Kanope59/DIY_PM/Doc/img/MFG_ABX00017.webp

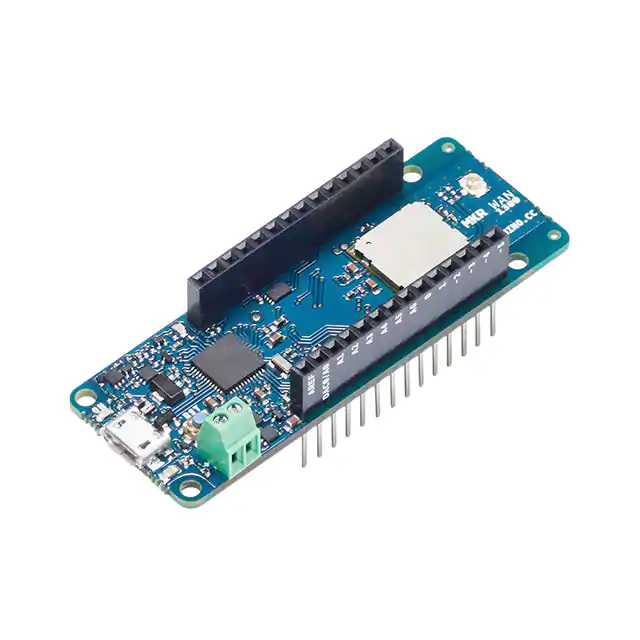
Doc/img/MFG_ABX00017.webp
