Kanope59/DIY_PM/Doc/Doc App.pdf

# Documentation Application kit PM

Partie élève | 2
Connexion | 2
Affichage des données | 3
Partie Professeur | 4
Connexion | 4
Création d’un groupe | 5

Auteur : Loïc Lawniczak

Version : 1.0

Date de révision : 01/02/2021

## Partie élève

### Connexion

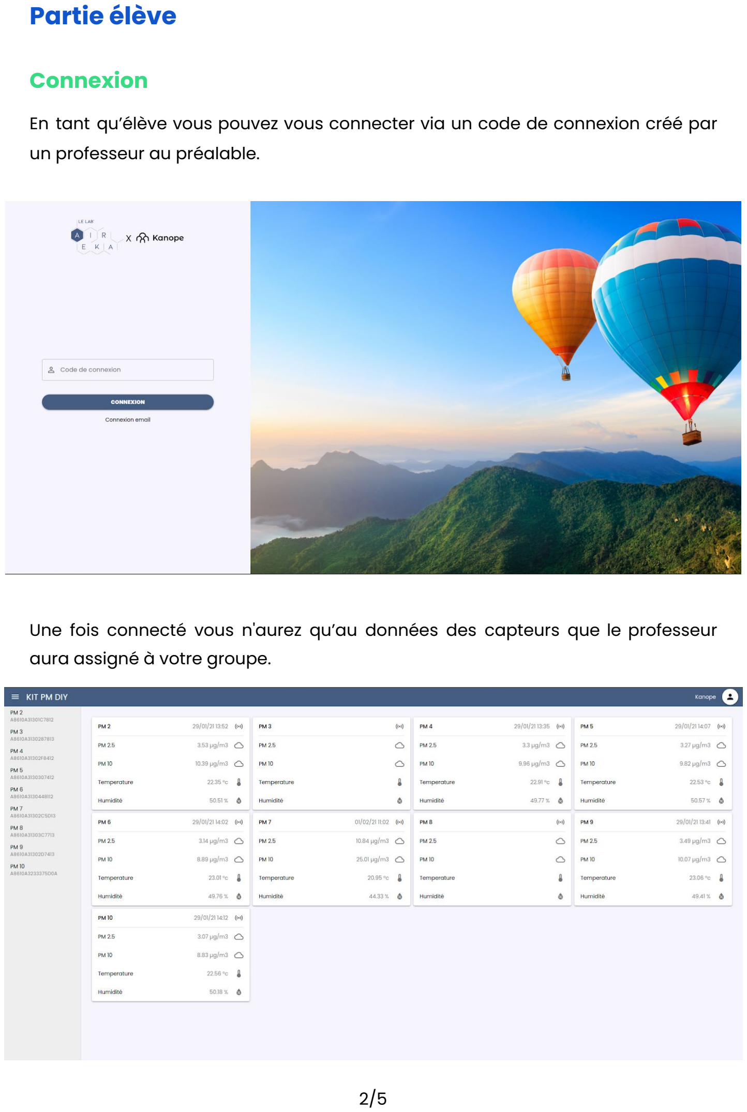
[picture p2: page 2]

En tant qu’élève vous pouvez vous connecter via un code de connexion créé par un professeur au préalable.

Une fois connecté vous n'aurez qu’au données des capteurs que le professeur aura assigné à votre groupe.

### Affichage des données

Dans le menu latéral vous pouvez sélectionner un ou plusieurs capteurs.
Si un seul capteur est sélectionné vous aurez accès à ses données, si vous en sélectionnez plusieurs, les graphiques affichent toutes les courbes ce qui vous permettra de les comparer.

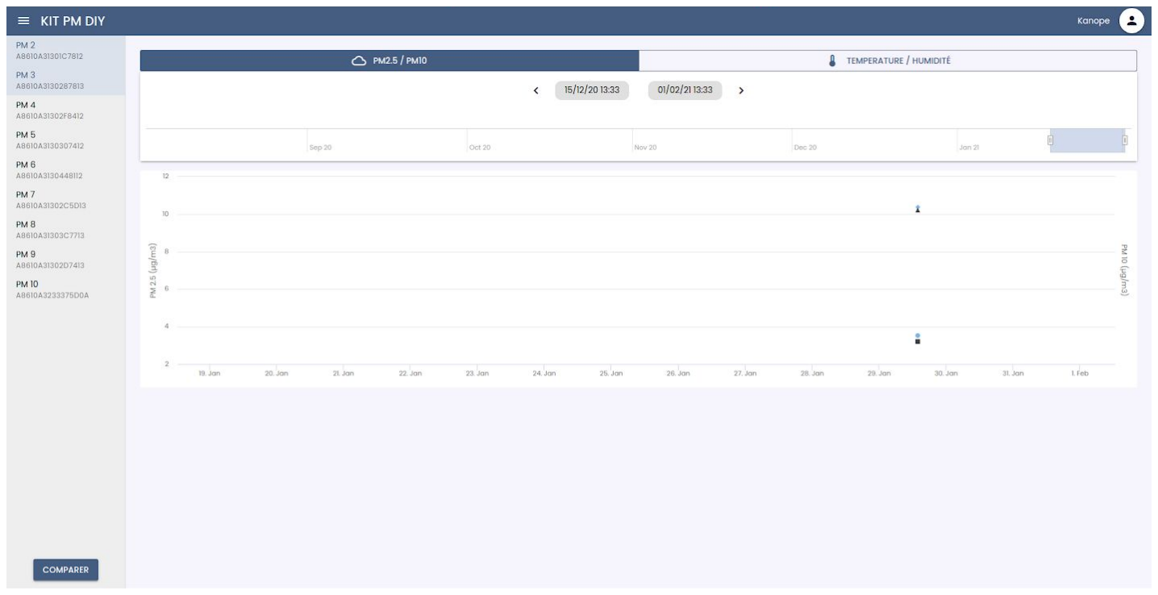
[picture p3: figure]

## Partie Professeur

### Connexion

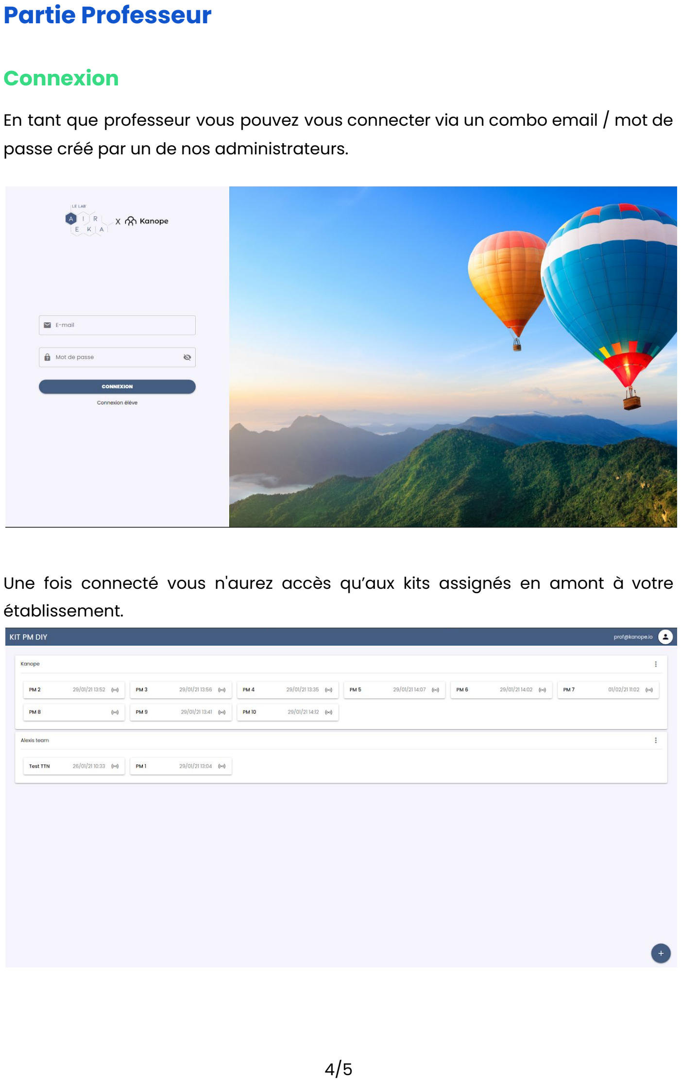
[picture p4: page 4]

En tant que professeur vous pouvez vous connecter via un combo email / mot de passe créé par un de nos administrateurs.

Une fois connecté vous n'aurez accès qu’aux kits assignés en amont à votre établissement.

### Création d’un groupe

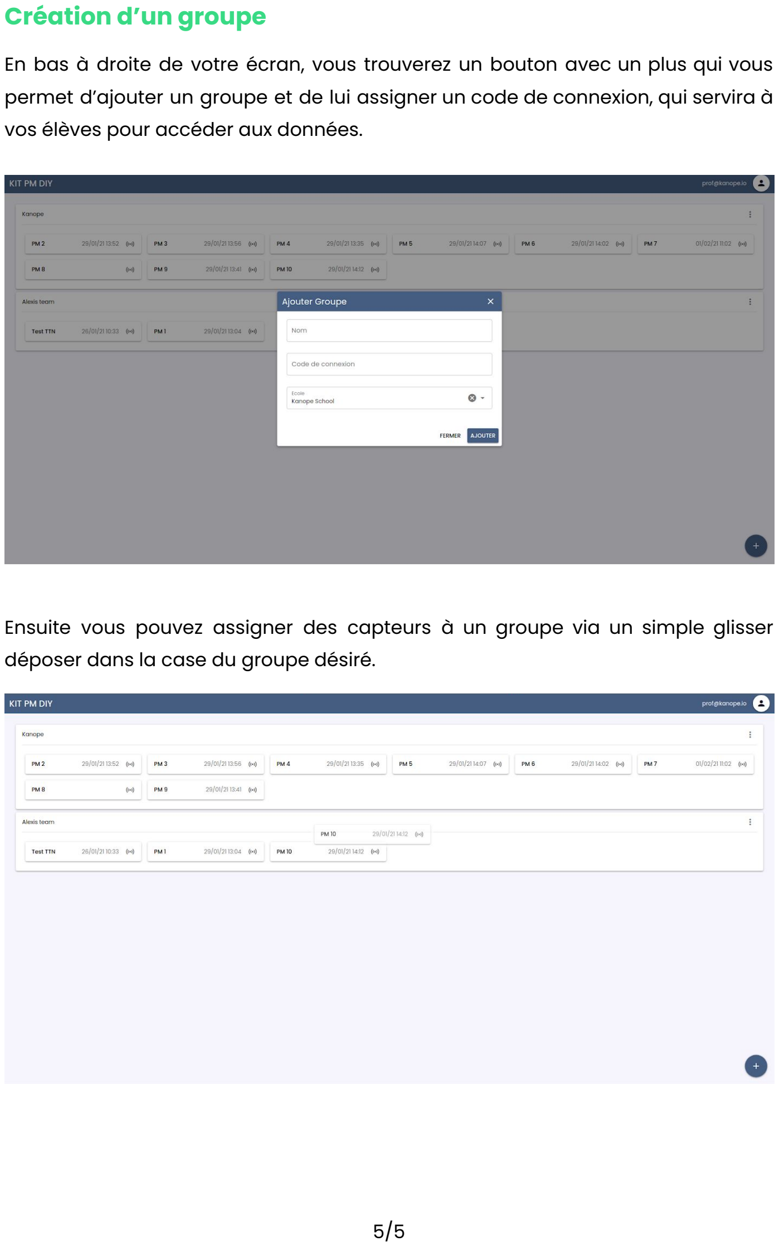
[picture p5: page 5]

En bas à droite de votre écran, vous trouverez un bouton avec un plus qui vous permet d’ajouter un groupe et de lui assigner un code de connexion, qui servira à vos élèves pour accéder aux données.

Ensuite vous pouvez assigner des capteurs à un groupe via un simple glisser déposer dans la case du groupe désiré.
