Kanope59/DIY_PM/Doc/img/41+2ruqOWnL._AC_SL1100_.jpg

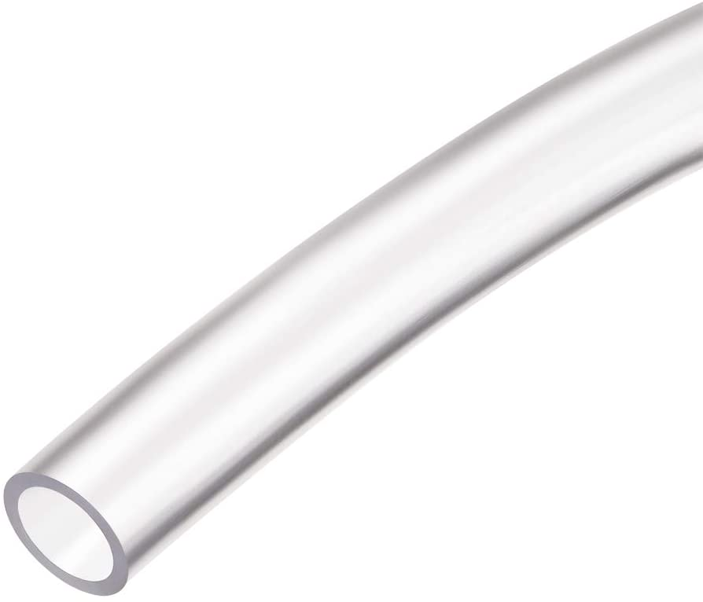
Doc/img/41+2ruqOWnL._AC_SL1100_.jpg
