Kanope59/DIY_PM/Doc/img/51ZyulYqHfL._AC_SL1280_.jpg

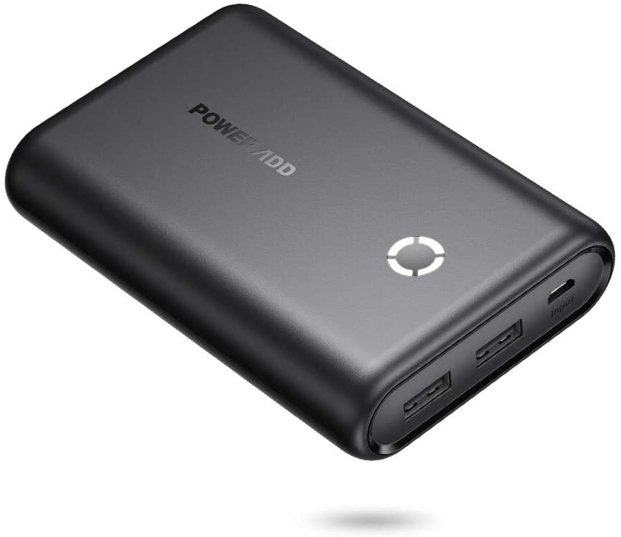
Doc/img/51ZyulYqHfL._AC_SL1280_.jpg
