Kanope59/DIY_PM/Doc/img/64300_1.jpg

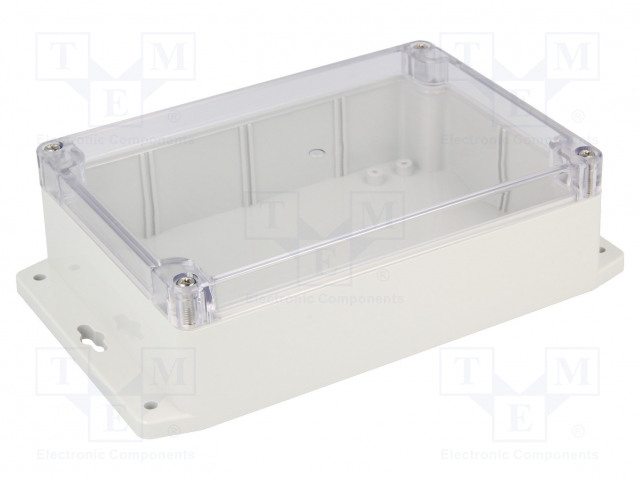
Doc/img/64300_1.jpg
