Kanope59/DIY_PM/Doc/img/ar-presse-etoupe-pg14-6374.jpg

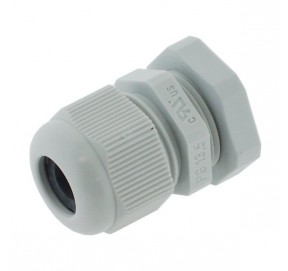
Doc/img/ar-presse-etoupe-pg14-6374.jpg
