Kanope59/DIY_PM/Doc/img/HPP828E031.webp

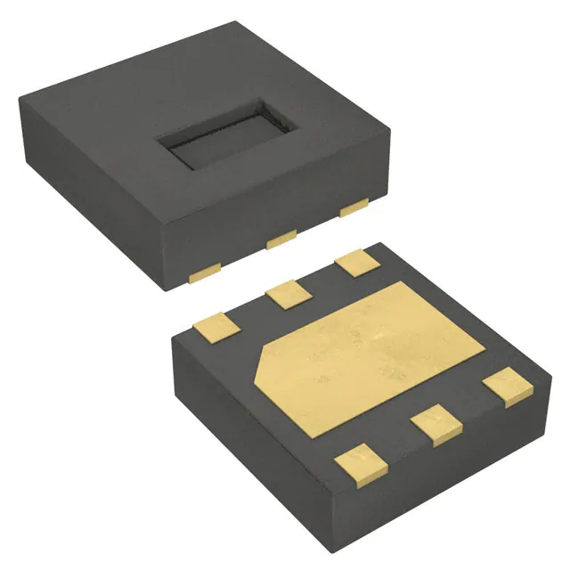
Doc/img/HPP828E031.webp
