Kanope59/DIY_PM/Doc/img/MFG_R30-3002002.webp

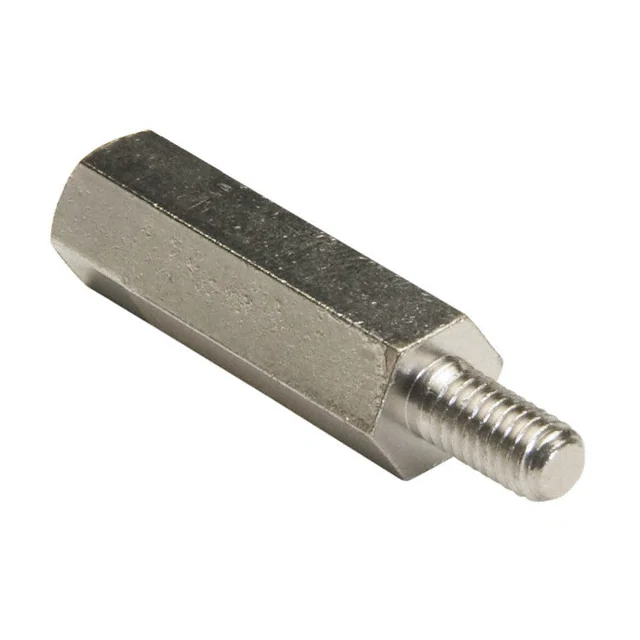
Doc/img/MFG_R30-3002002.webp
