Kanope59/DIY_PM/Doc/img/MFG_X000016.webp

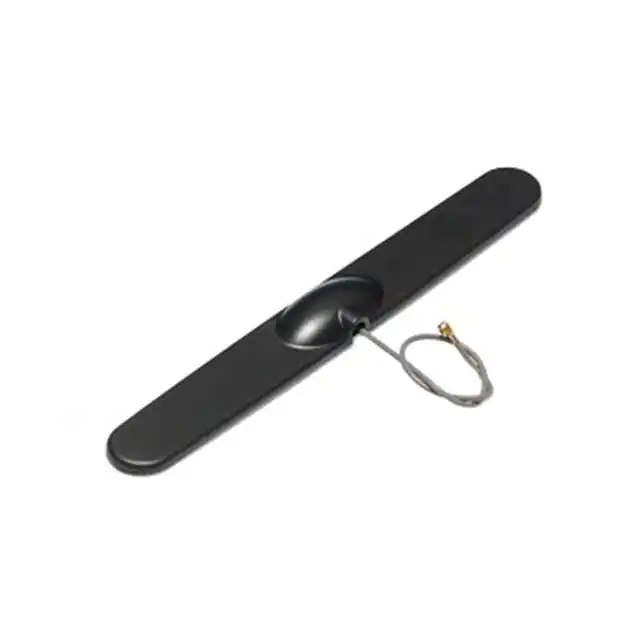
Doc/img/MFG_X000016.webp
