Kanope59/DIY_PM/Doc/img/MHNZ-003.webp

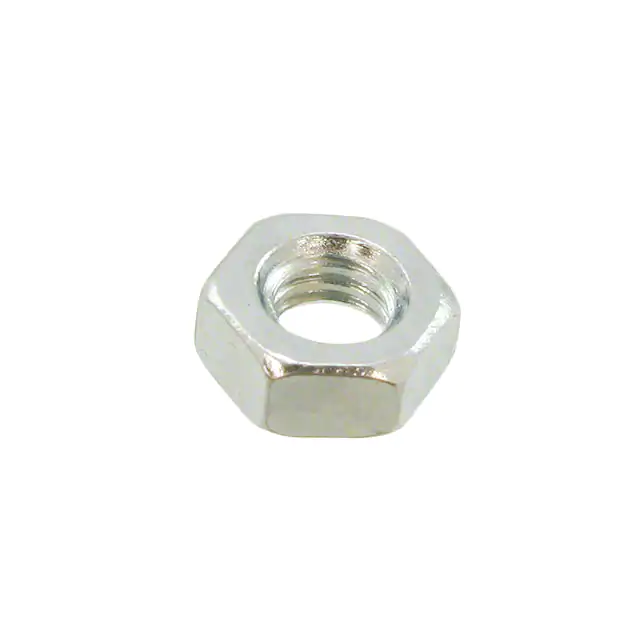
Doc/img/MHNZ-003.webp
