Kanope59/DIY_PM/Doc/img/SDS011.jpg

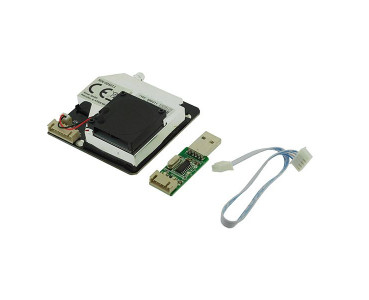
Doc/img/SDS011.jpg
