Kanope59/DIY_PM/Doc/humidity.step

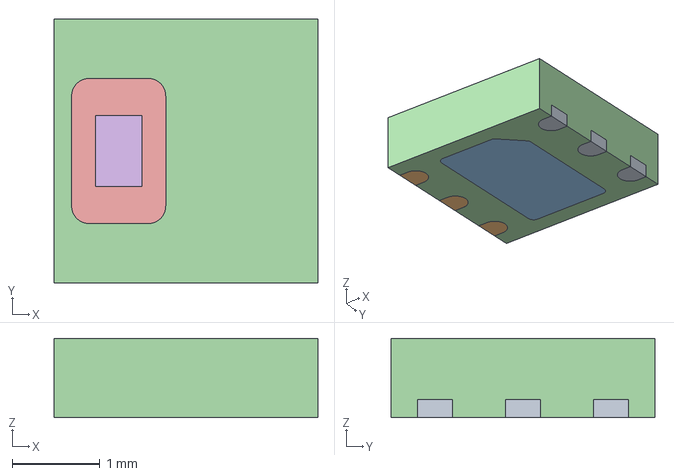
[picture p15: CAD file, 2021-01-19]
Doc/humidity.step
3.00 x 3.00 x 0.9 mm
