Kanope59/DIY_PM/Doc/PMsensor.step

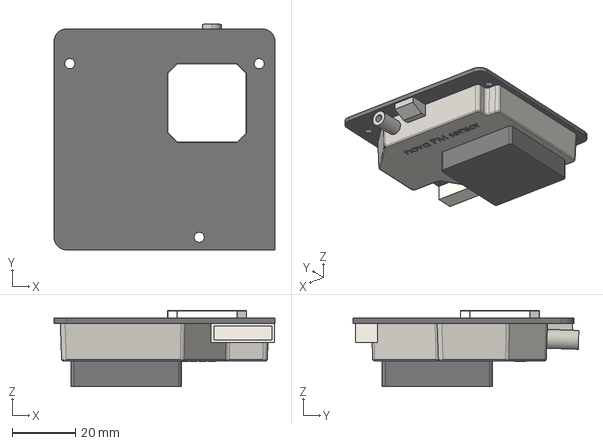
[picture p16: CAD file, 2021-01-19]
Doc/PMsensor.step
70.0 x 71.5 x 24.2 mm
