Kanope59/DIY_PM/Doc/DIY.step

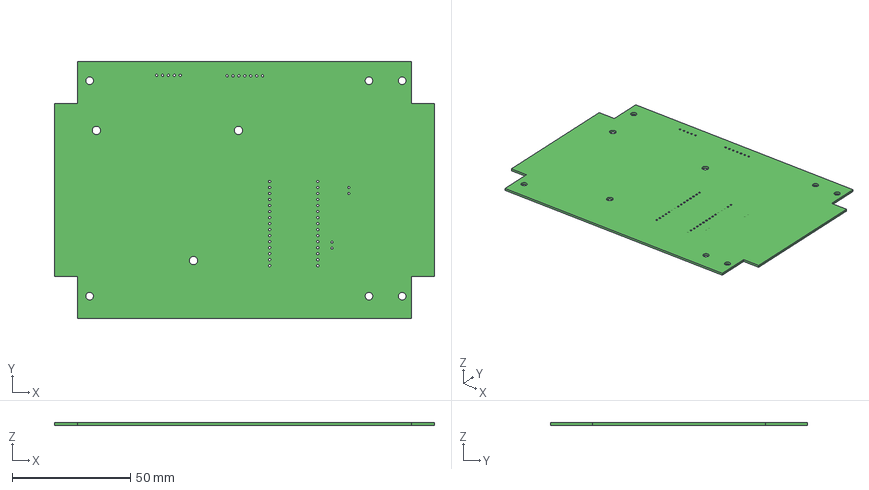
[picture p17: CAD file, 2021-01-19]
Doc/DIY.step
160.5 x 108.6 x 1.12 mm
