Kanope59/DIY_PM/Doc/arduino-mkr-1300-wan.step

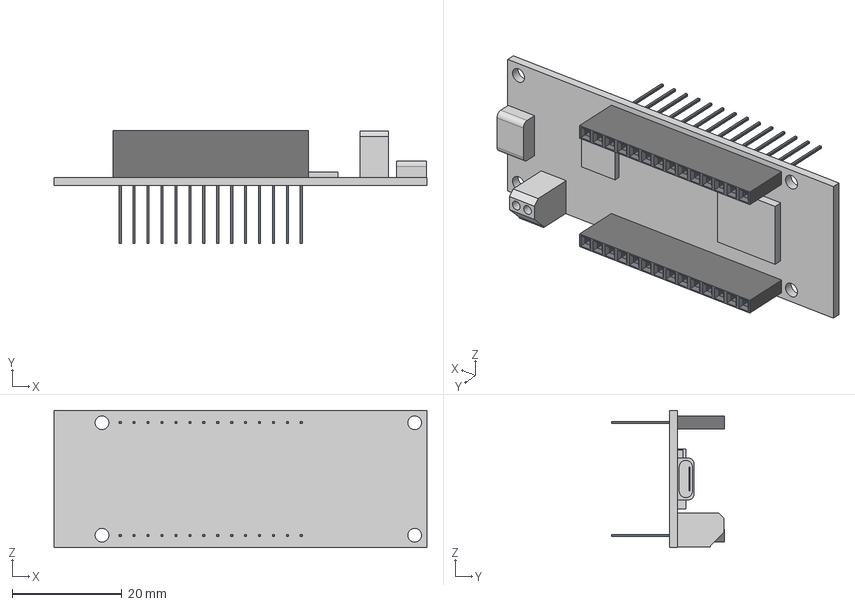
[picture p18: CAD file, 2021-01-19]
Doc/arduino-mkr-1300-wan.step
68.0 x 20.5 x 25.0 mm
pcb
14-pin-header x 2
