Kanope59/DIY_PM/(commit log)

2021-01-19 Comit with docs and app up to date.
    [BOM_20210106.xlsx, Battery.xlsx, DIY.step, PMsensor.step, arduino-mkr-1300-wan.step, humidity.step]
2021-02-01 Commit: Update Doc d'installation, Ajout Doc app Web, Modification du BOM
    [BOM_20210106.xlsx]
